markpope/CheesePress/images/CircuitDiagram.jpg

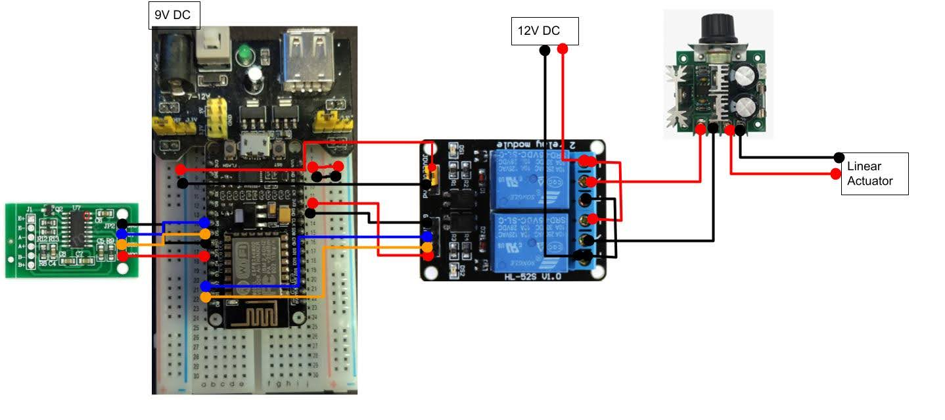
images/CircuitDiagram.jpg
